xan1ameba/inksolar/cad/assembly/solar_tracker_FULL_ASSEMBLY.step

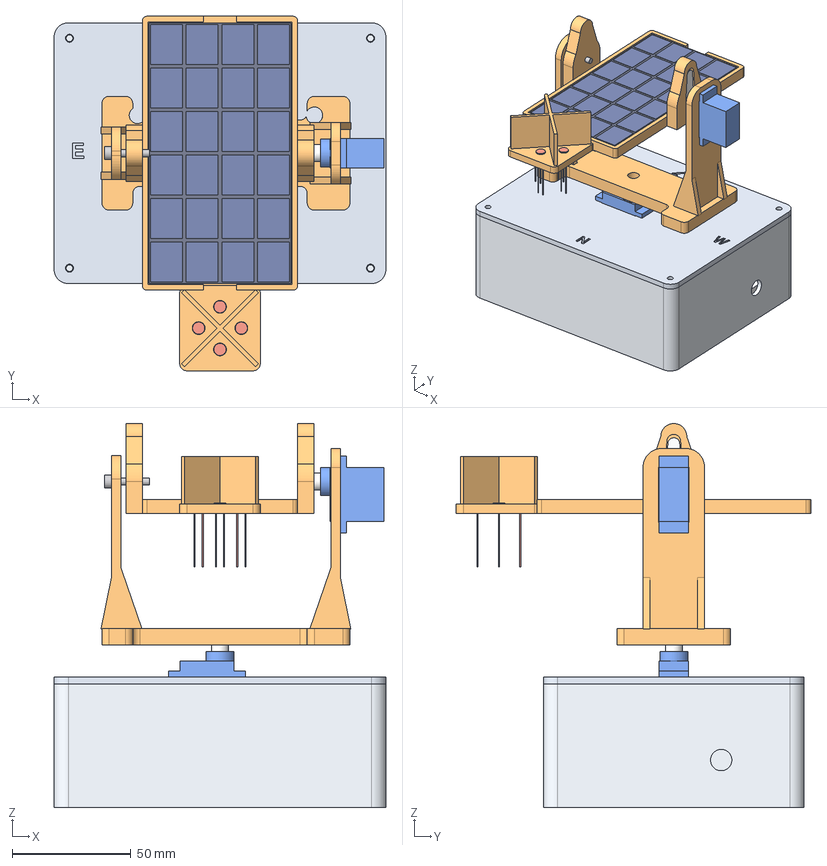
[picture p8: CAD file, 2026-10-27]
cad/assembly/solar_tracker_FULL_ASSEMBLY.step
140.0 x 149.6 x 162.0 mm
1_base_box
2_base_lid
arduino_uno_pcb
arduino_usb_dc
arduino_headers
mini_breadboard
servo_pan_SG90
horn_pan
3_yoke
servo_tilt_SG90
horn_tilt
M3x16_pivot_bolt
4_panel_frame
solar_panel
solar_cells
LDR_top_N
LDR_bottom_S
LDR_east
LDR_west
