xan1ameba/inksolar/cad/step/4_panel_frame.step

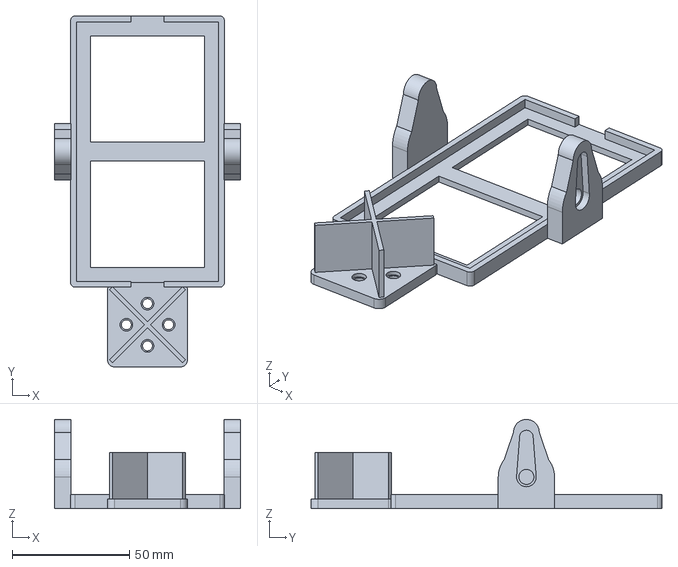
[picture p9: CAD file, 2026-10-27]
cad/step/4_panel_frame.step
79.4 x 149.6 x 38.0 mm
