xan1ameba/inksolar/cad/step/3_yoke.step

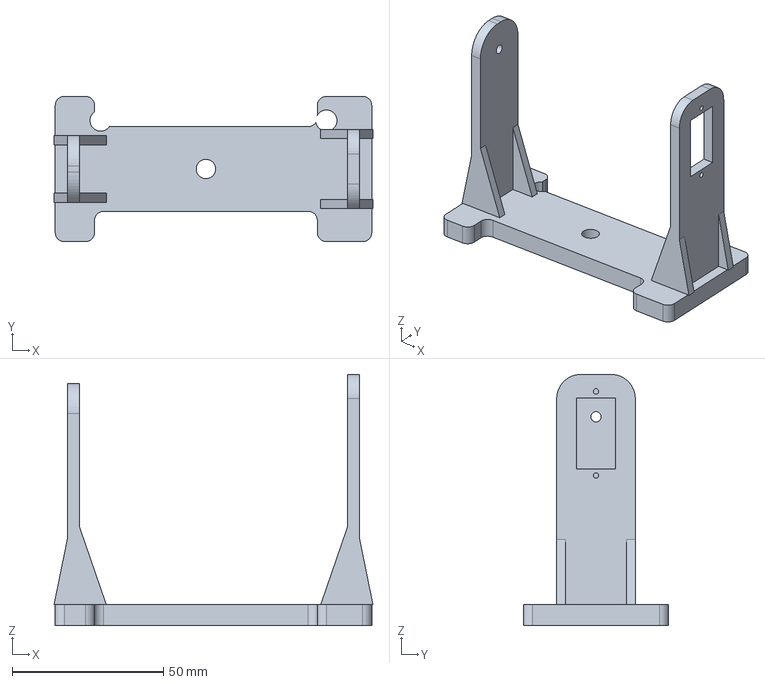
[picture p10: CAD file, 2026-10-27]
cad/step/3_yoke.step
105.4 x 48.0 x 83.0 mm
