xan1ameba/inksolar/cad/step/1_base_box.step

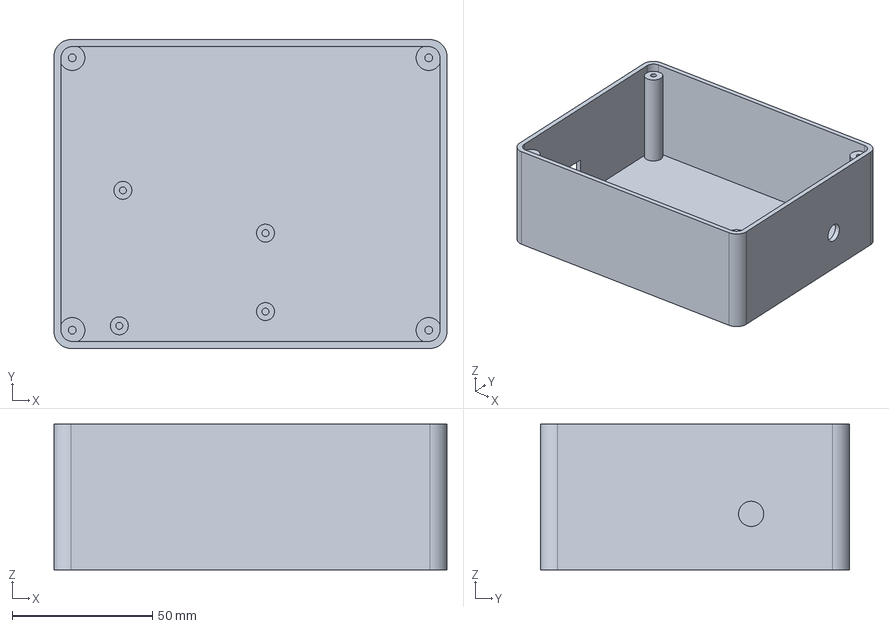
[picture p11: CAD file, 2026-10-27]
cad/step/1_base_box.step
140.0 x 110.0 x 52.0 mm
