xan1ameba/inksolar/cad/step/2_base_lid.step

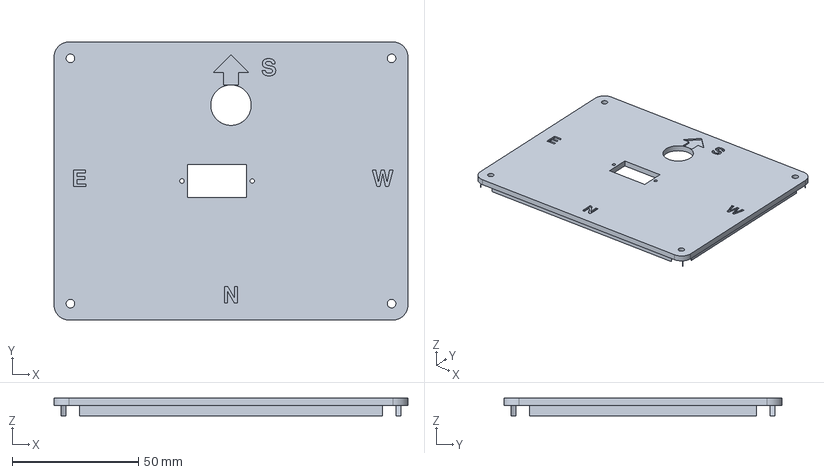
[picture p12: CAD file, 2026-10-27]
cad/step/2_base_lid.step
140.0 x 110.0 x 7.00 mm
