xan1ameba/inksolar/(list of files, cad)

Other CAD files:
cad/stl/1_base_box.stl
cad/stl/2_base_lid.stl
cad/stl/3_yoke.stl
cad/stl/4_panel_frame.stl
